DavidKutu/search_rescue_robot/gripper/fotos.pptx

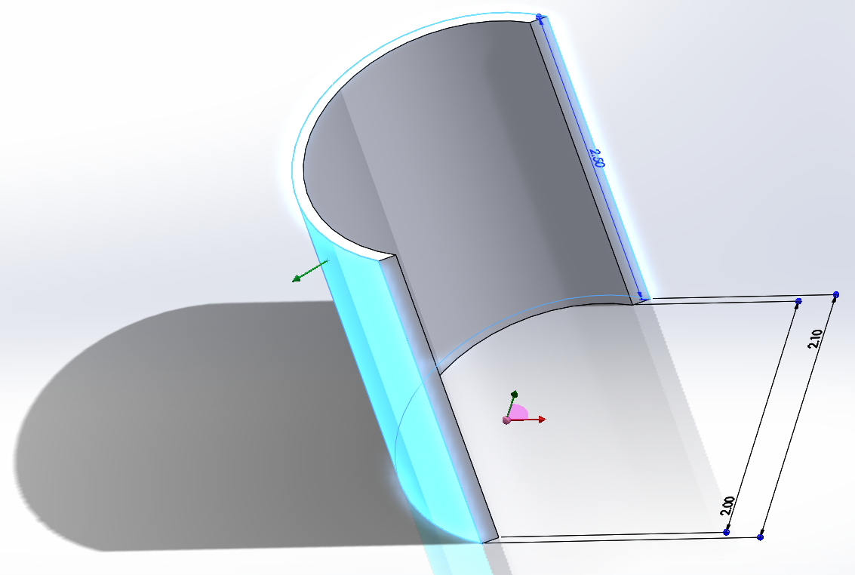
[picture p33: figure]

## Slide 2

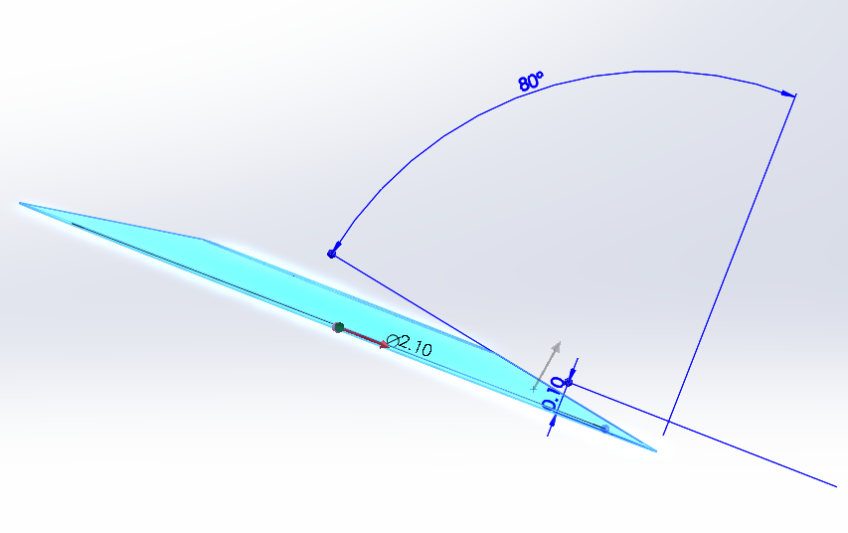
[picture p34: figure]

## Slide 3

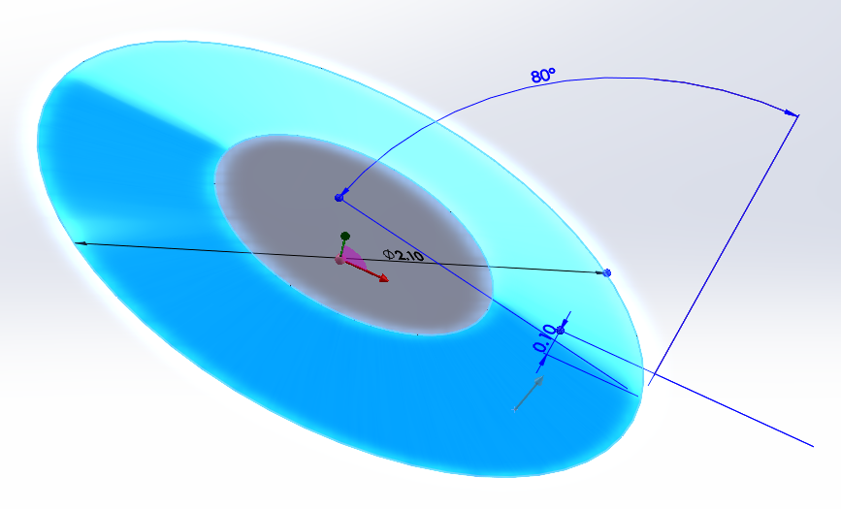
[picture p35: figure]

## Slide 4

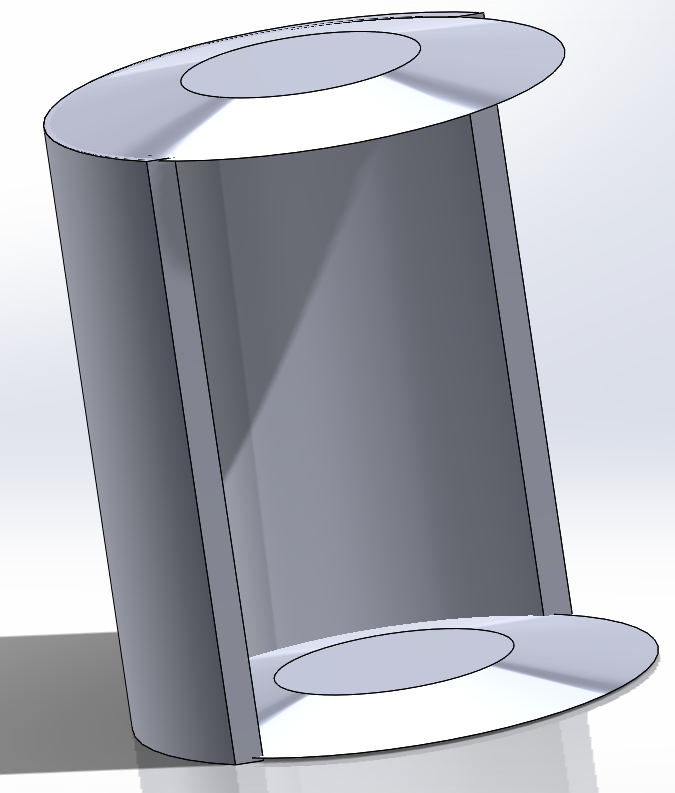
[picture p36: figure]

## Slide 5

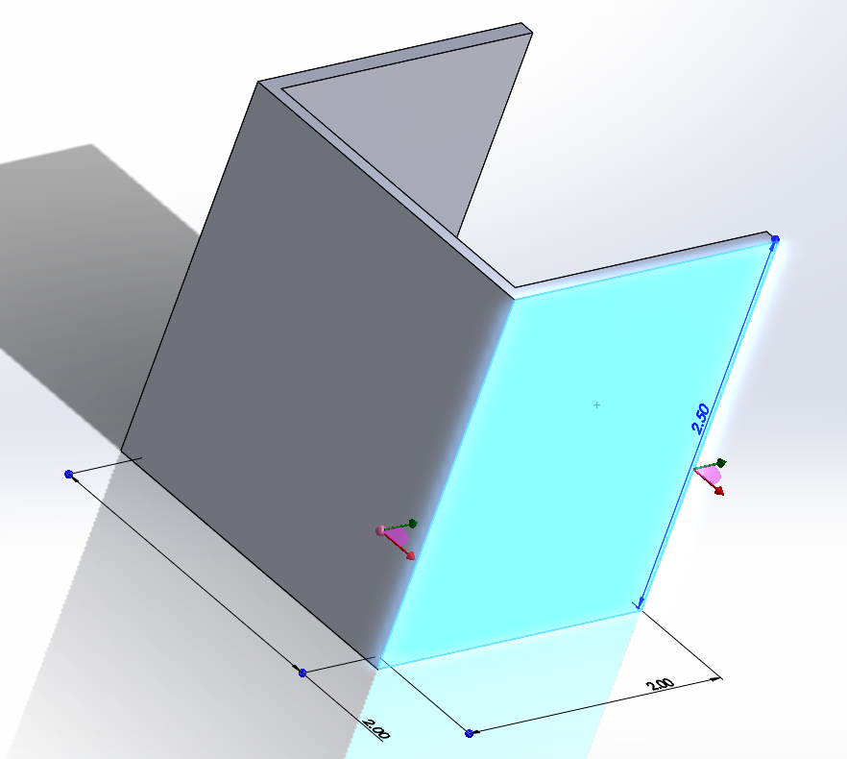
[picture p37: figure]

## Slide 6

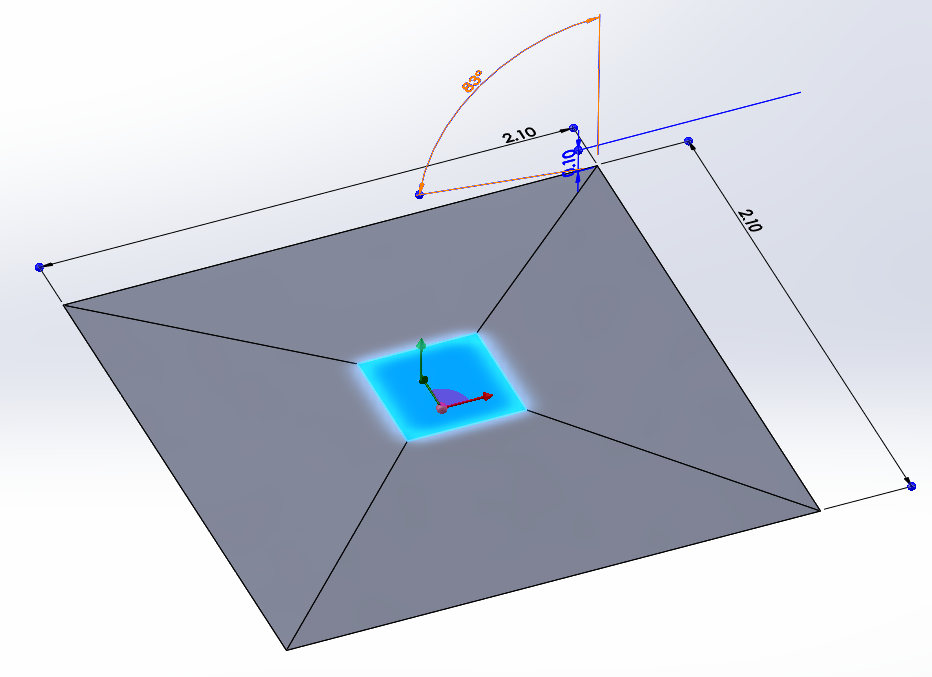
[picture p38: figure]

## Slide 7

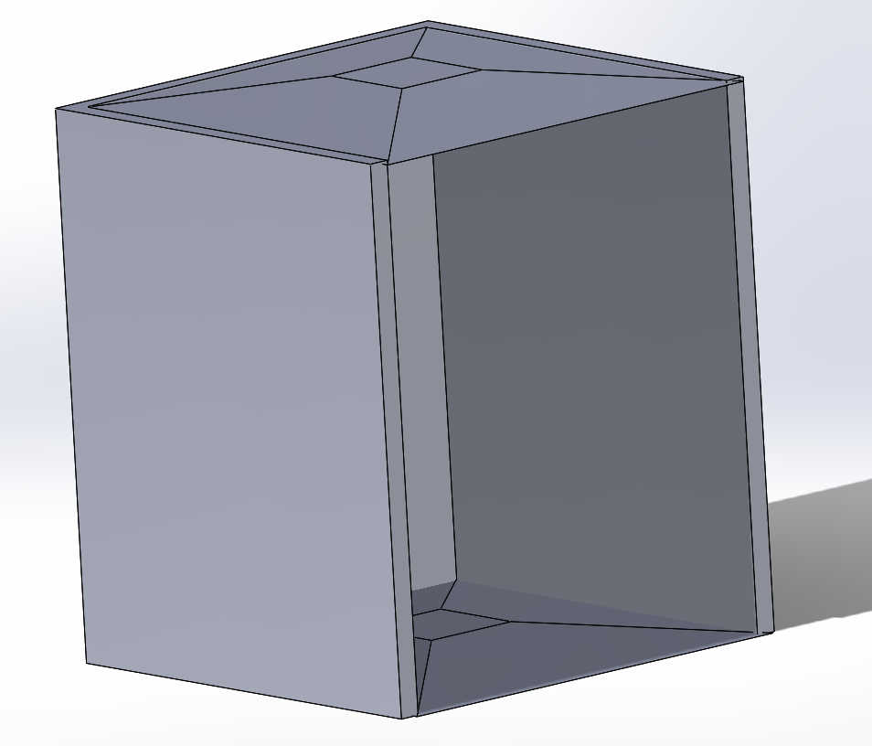
[picture p39: figure]

## Slide 8

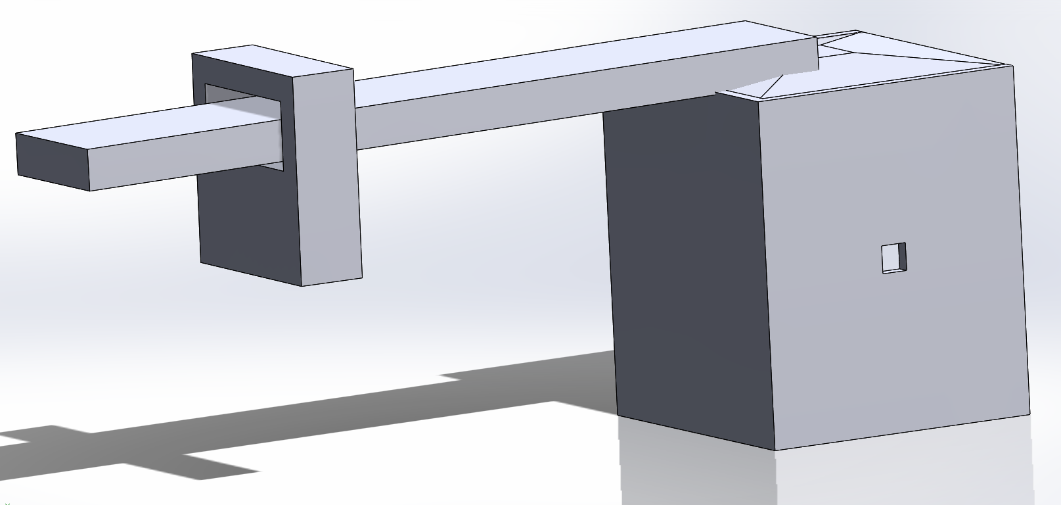
[picture p40: figure]

## Slide 9

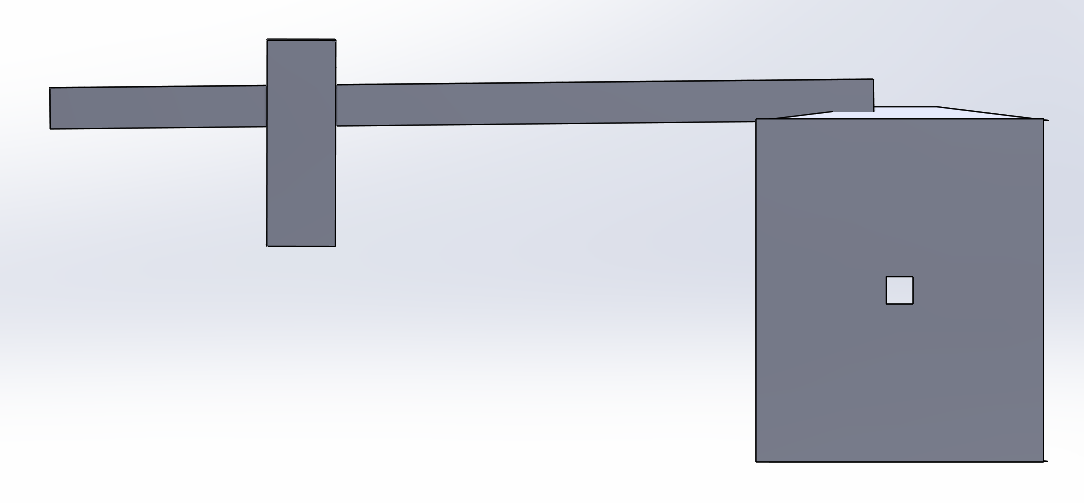
[picture p41: figure]

## Slide 10

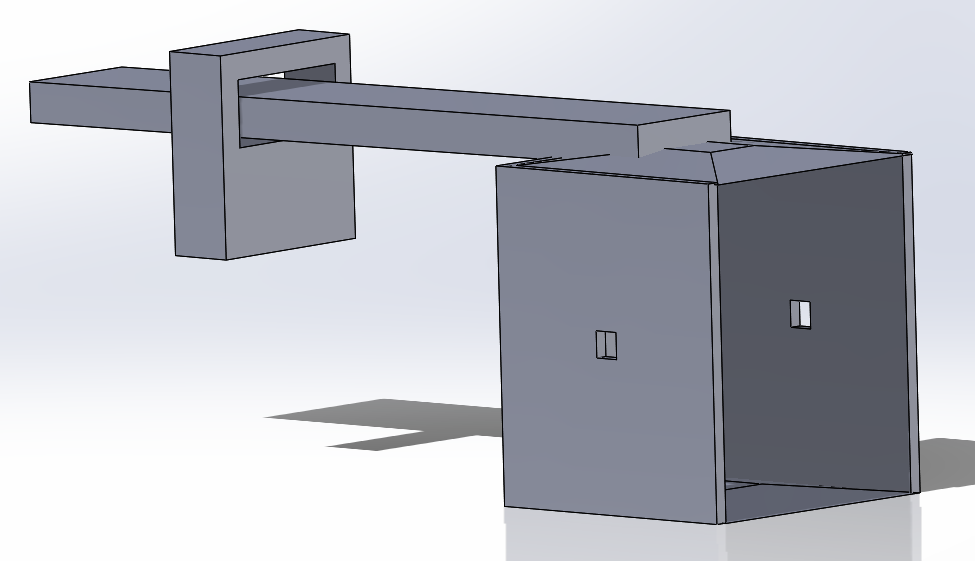
[picture p42: figure]
