DavidKutu/search_rescue_robot/gripper/solidworks project/canasta_cuadrada.SLDASM

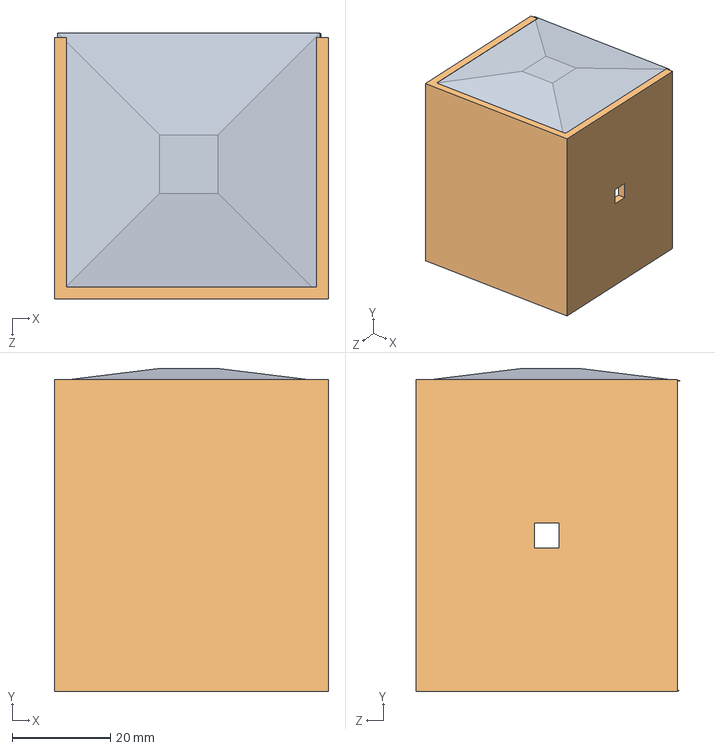
[picture p45: CAD file, 2016-09-04]
gripper/solidworks project/canasta_cuadrada.SLDASM
55.8 x 65.7 x 54.1 mm
base_canasta2 x 2
pared_cansta2
