DavidKutu/search_rescue_robot/gripper/solidworks project/canasta_redonda.SLDASM

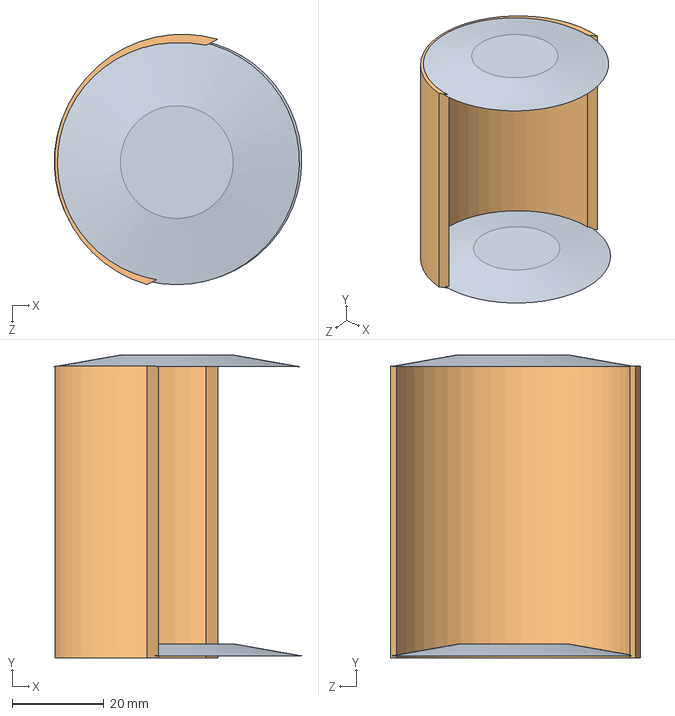
[picture p46: CAD file, 2016-09-04]
gripper/solidworks project/canasta_redonda.SLDASM
53.8 x 65.9 x 54.5 mm
base_canasta x 2
pared_canasta
