DavidKutu/search_rescue_robot/gripper/solidworks project/sistema_de_agarre.SLDASM

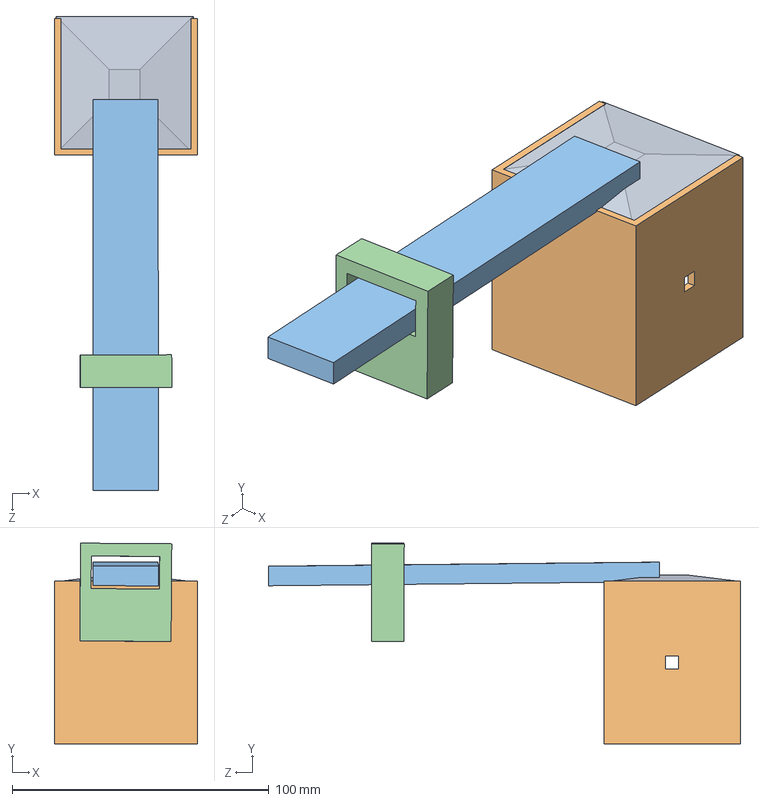
[picture p47: CAD file, 2016-09-04]
gripper/solidworks project/sistema_de_agarre.SLDASM
55.8 x 78.2 x 184.7 mm
base_canasta2 x 2
pared_cansta2
palanca
pivote
