DavidKutu/search_rescue_robot/gripper/solidworks project/base_canasta.SLDPRT

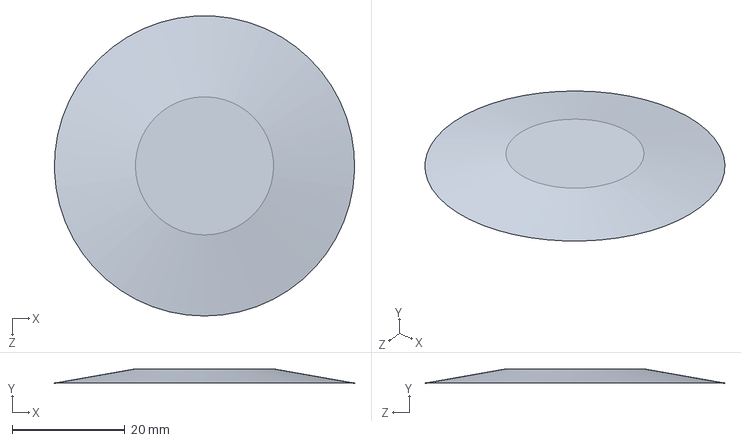
[picture p48: CAD file, 2016-09-04]
gripper/solidworks project/base_canasta.SLDPRT
53.3 x 2.54 x 53.3 mm
