DavidKutu/search_rescue_robot/gripper/solidworks project/palanca.SLDPRT

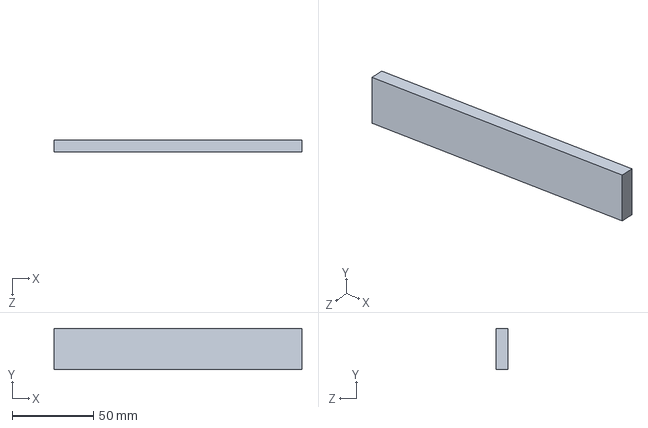
[picture p49: CAD file, 2016-09-04]
gripper/solidworks project/palanca.SLDPRT
152.4 x 25.4 x 7.62 mm
