DavidKutu/search_rescue_robot/gripper/solidworks project/pared_cansta2.SLDPRT

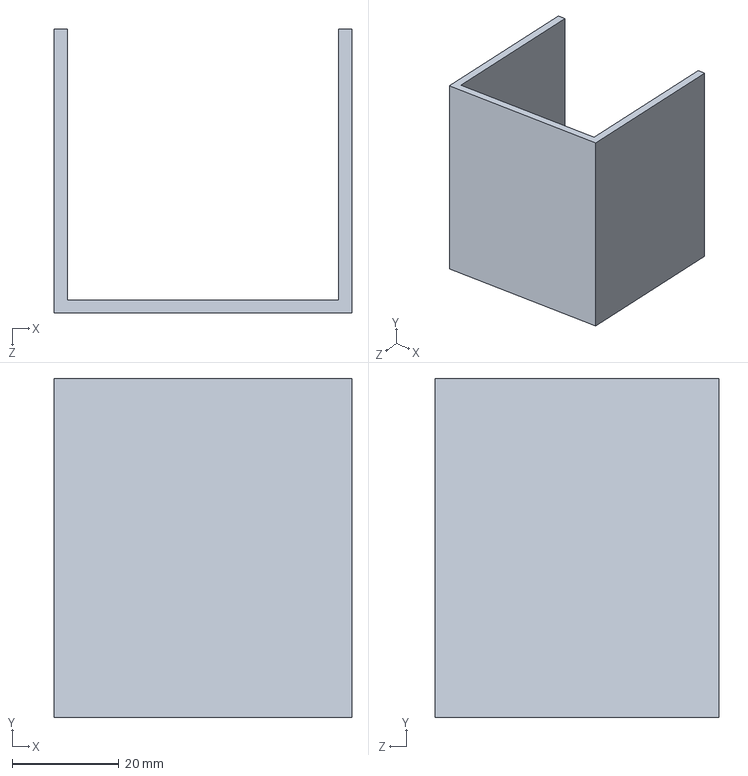
[picture p50: CAD file, 2016-09-04]
gripper/solidworks project/pared_cansta2.SLDPRT
55.8 x 63.5 x 53.2 mm
