DavidKutu/search_rescue_robot/gripper/solidworks project/pivote.SLDPRT

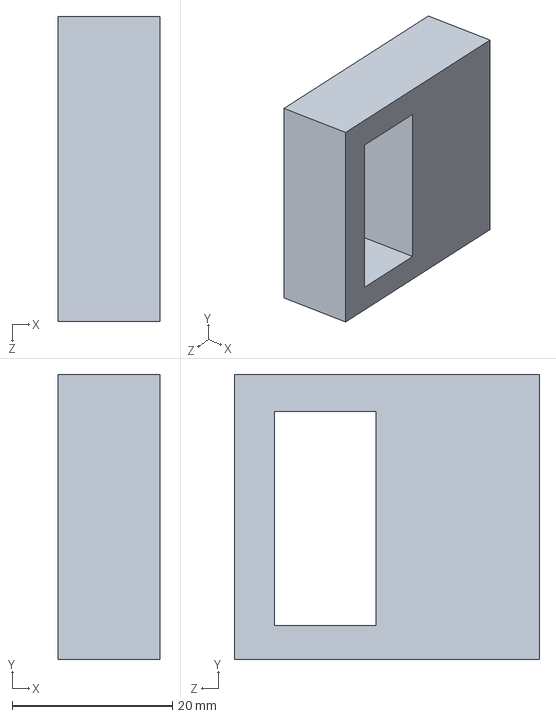
[picture p51: CAD file, 2016-09-04]
gripper/solidworks project/pivote.SLDPRT
12.7 x 35.6 x 38.1 mm
