DavidKutu/search_rescue_robot/gripper/solidworks project/base_canasta2.SLDPRT

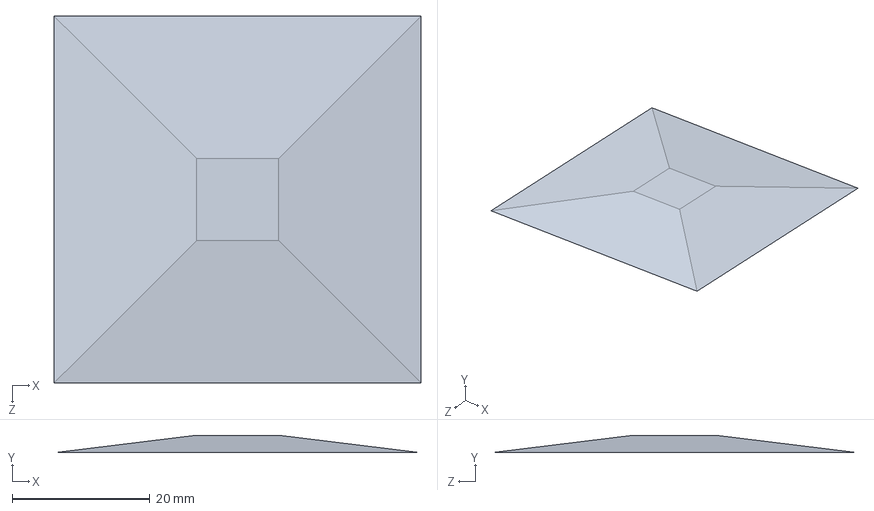
[picture p52: CAD file, 2016-09-04]
gripper/solidworks project/base_canasta2.SLDPRT
53.3 x 2.54 x 53.3 mm
