DavidKutu/search_rescue_robot/gripper/solidworks project/pared_canasta.SLDPRT

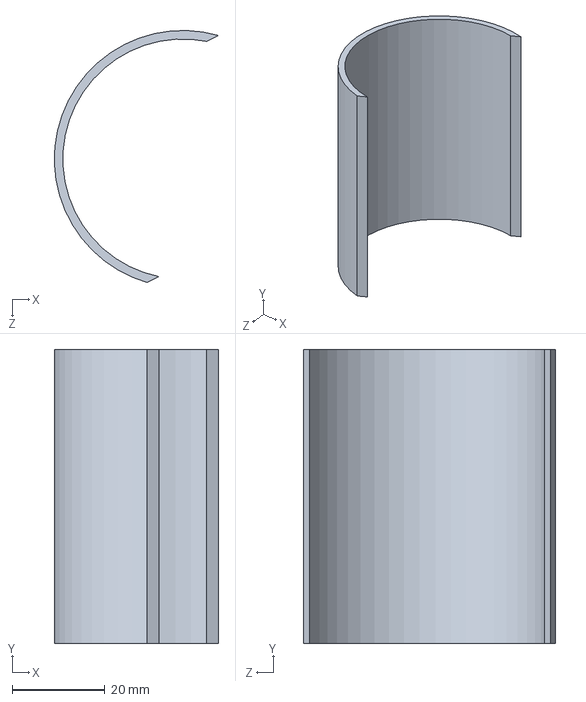
[picture p53: CAD file, 2016-09-04]
gripper/solidworks project/pared_canasta.SLDPRT
35.5 x 63.5 x 54.4 mm
