DavidKutu/search_rescue_robot/(list of files, cad)

Other CAD files:
gripper/Gripper-PR2016.skp
